thoms6johny/Smart-Valve-Controller/Water-Valve-Controller/Hardware/Schematics/Schematic_Water_Pump_Control.pdf

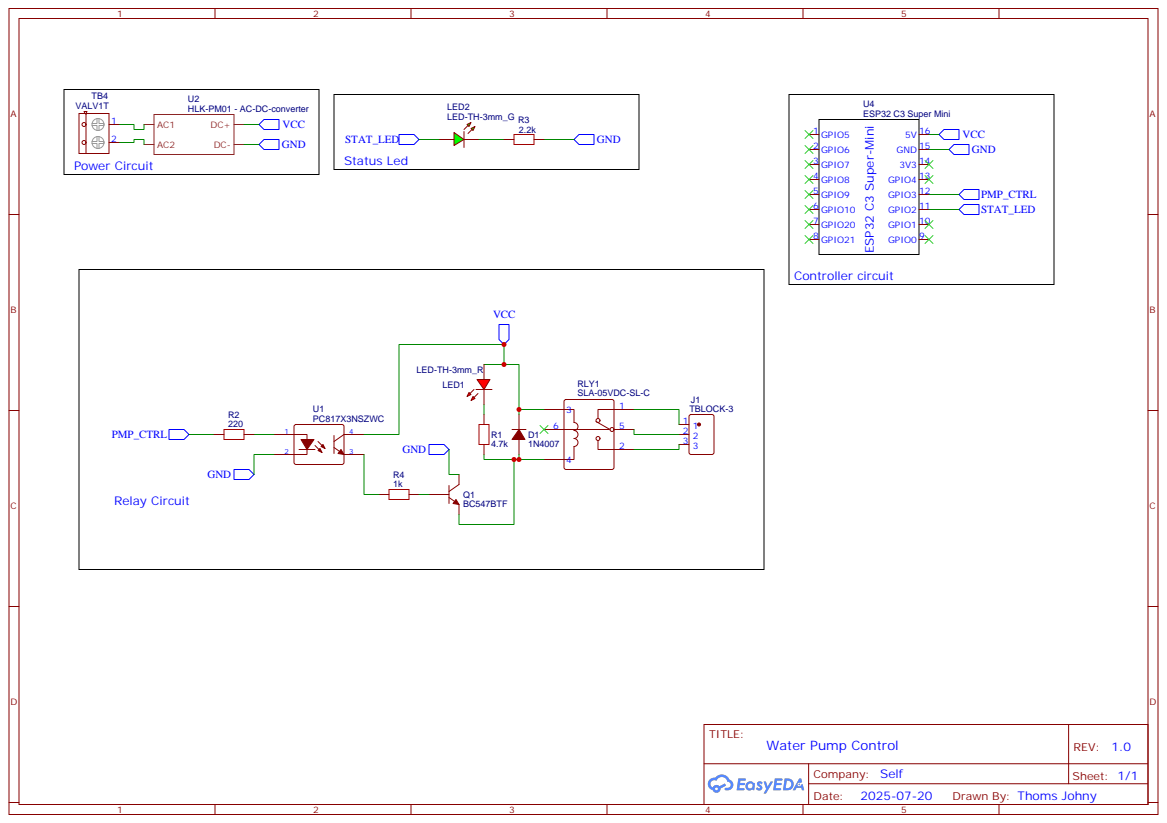
[picture p1: page 1]

Drawn By: Thoms Johny
