thoms6johny/Smart-Valve-Controller/Water-Valve-Controller/Hardware/Schematics/Schematic_Water_Valve_Control.pdf

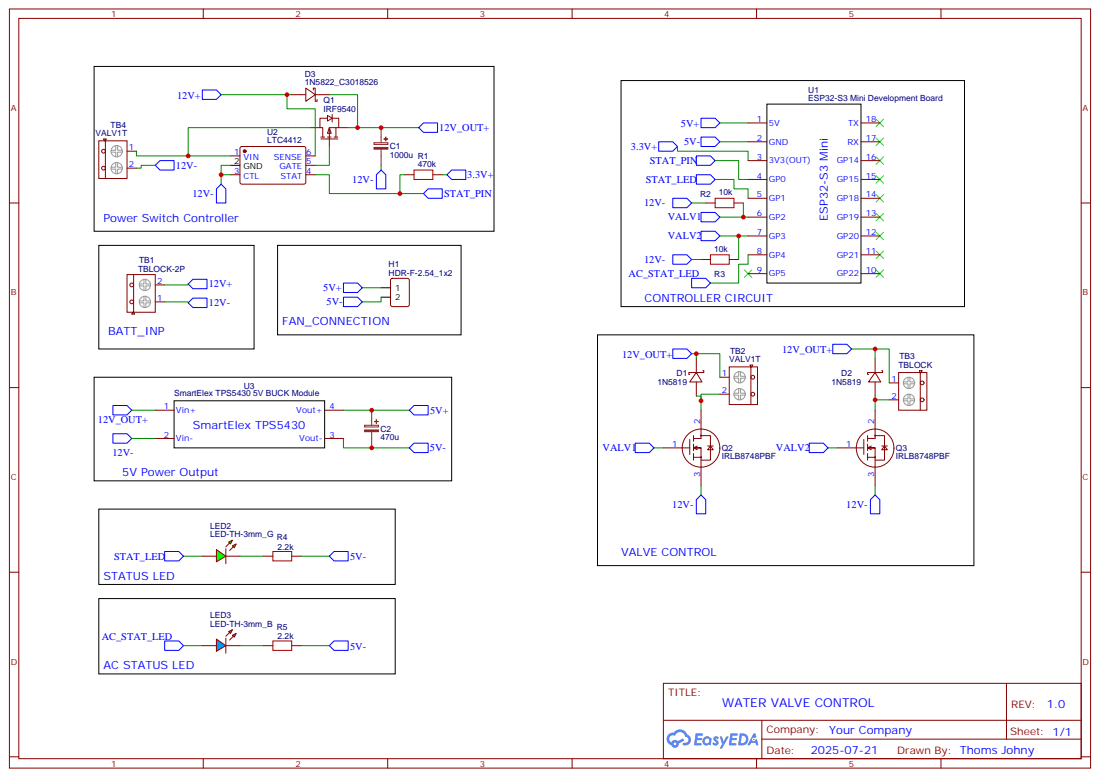
[picture p2: page 1]

Drawn By: Thoms Johny
