thoms6johny/Smart-Valve-Controller/Gas-Valve-Controller/Hardware/Schematics/Schematic_Gas_Valve_Control.pdf

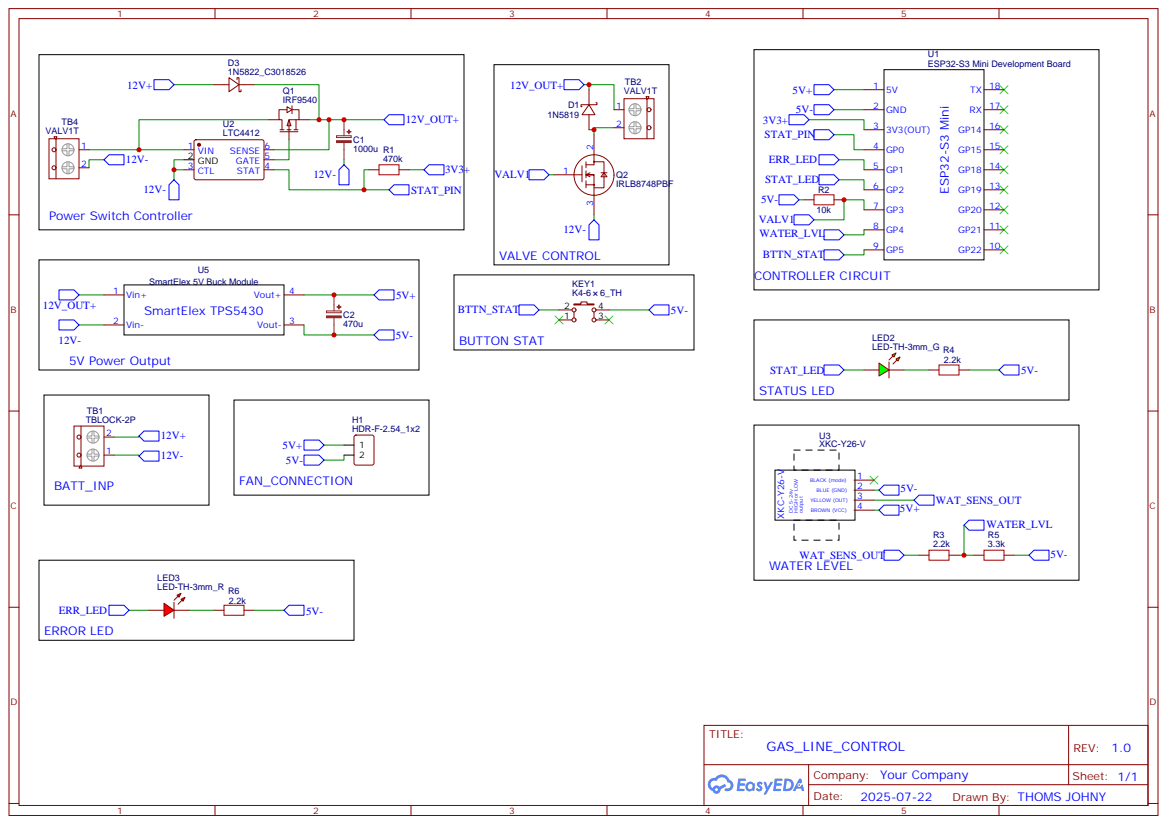
[picture p3: page 1]

Drawn By: THOMS JOHNY
