thoms6johny/Smart-Valve-Controller/Water-Valve-Controller/Hardware/PCB_Design/PDFs/PCB_Water_Pump_Control.pdf

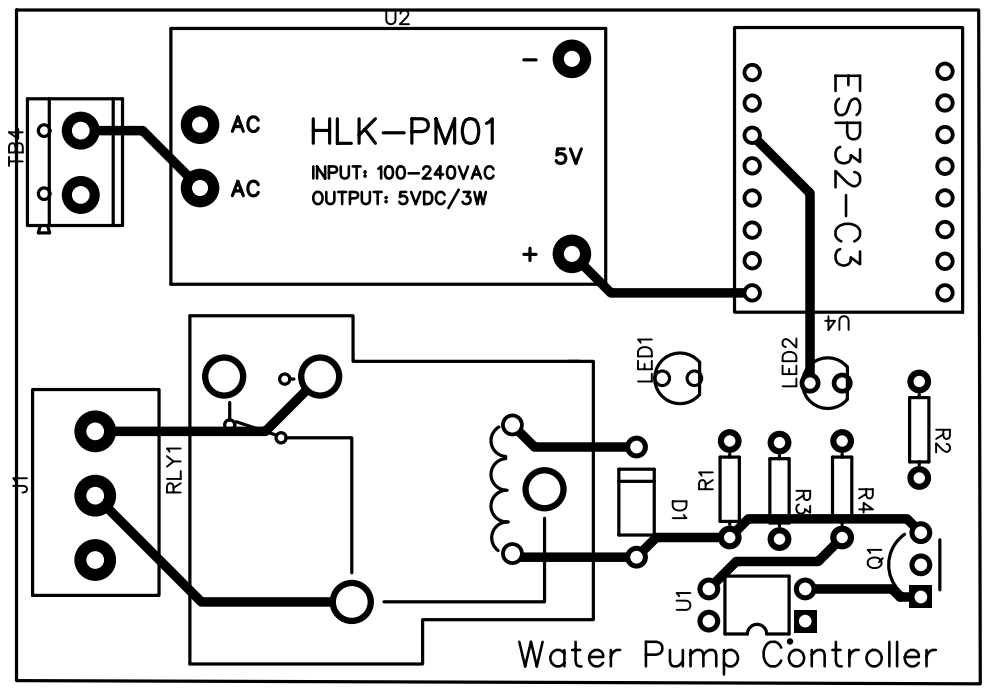
[picture p4: page 1]
