thoms6johny/Smart-Valve-Controller/Water-Valve-Controller/Hardware/PCB_Design/PDFs/PCB_Water_Valve_Control.pdf

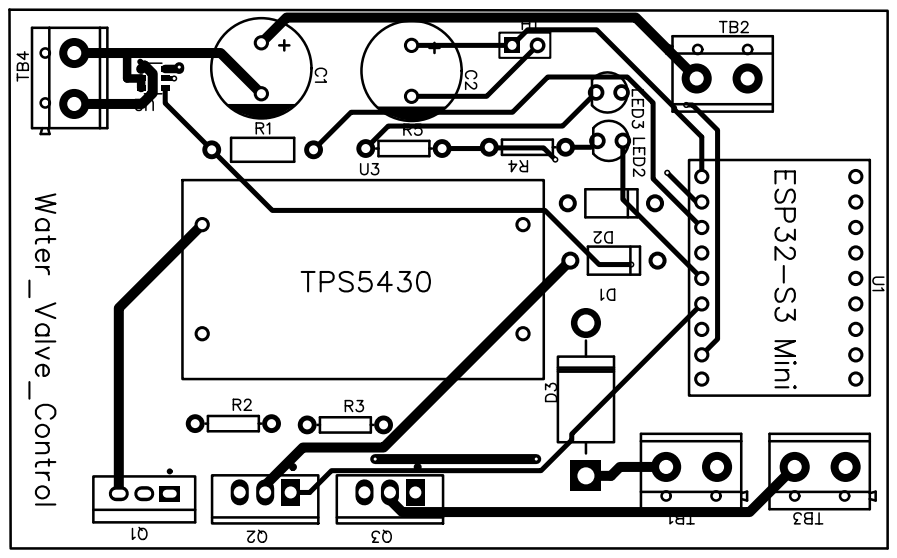
[picture p5: page 1]
