thoms6johny/Smart-Valve-Controller/Gas-Valve-Controller/Hardware/PCB_Design/PDF/PCB_Gas_Valve_Control.pdf

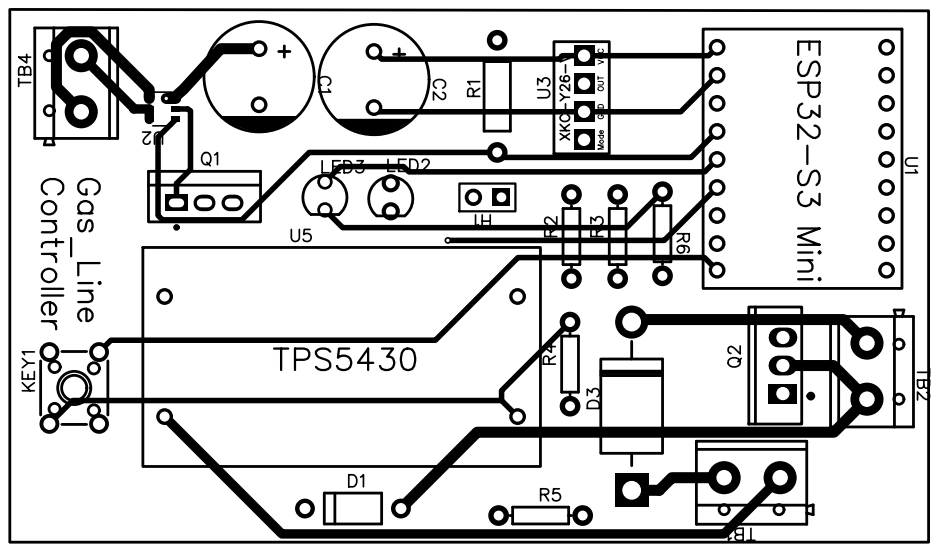
[picture p6: page 1]
