thoms6johny/Smart-Valve-Controller/(list of files, drawings)

Other design files:
Gas-Valve-Controller/Hardware/PCB_Design/JSON/PCB_Gas_Valve_Control.json
Water-Valve-Controller/Hardware/PCB_Design/JSON/PCB_Water_Pump_Control.json
Water-Valve-Controller/Hardware/PCB_Design/JSON/PCB_Water_Valve_Control.json
