thoms6johny/Smart-Valve-Controller/(commit log)

2025-09-09 Water Valve Control Initial
2025-09-09 Update README.md
    Removed images of prototype
